twfth9/PiZero_RTL_Panadapter/README.md

# PiZero_RTL_Panadapter
Rasp Pi Zero, RTLSDR-based panadapter module
