twfth9/PiZero_RTL_Panadapter/Modules/SDR_2832U_R820T2/SDR_2832U_R820T2.kicad_pcb

## KiCad design Modules/SDR_2832U_R820T2/SDR_2832U_R820T2.kicad_pcb (2026-09-03)

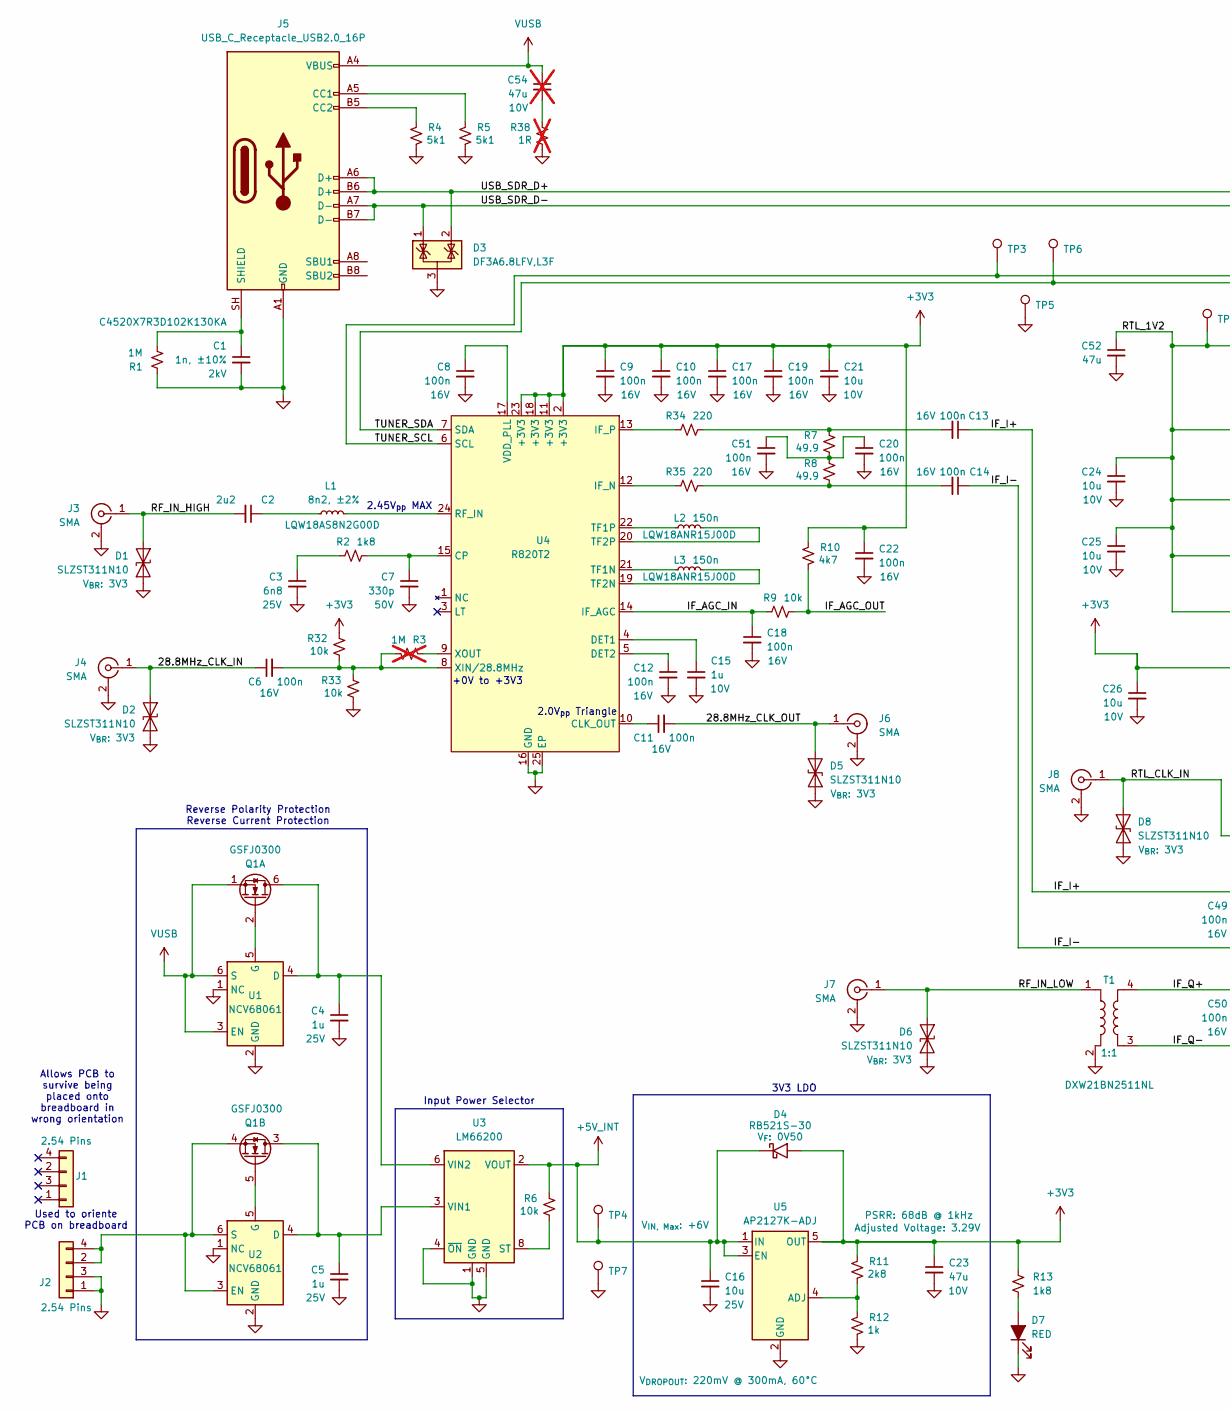
[picture p1: schematic SDR_2832U_R820T2.kicad_sch, part in row 1, column 1]

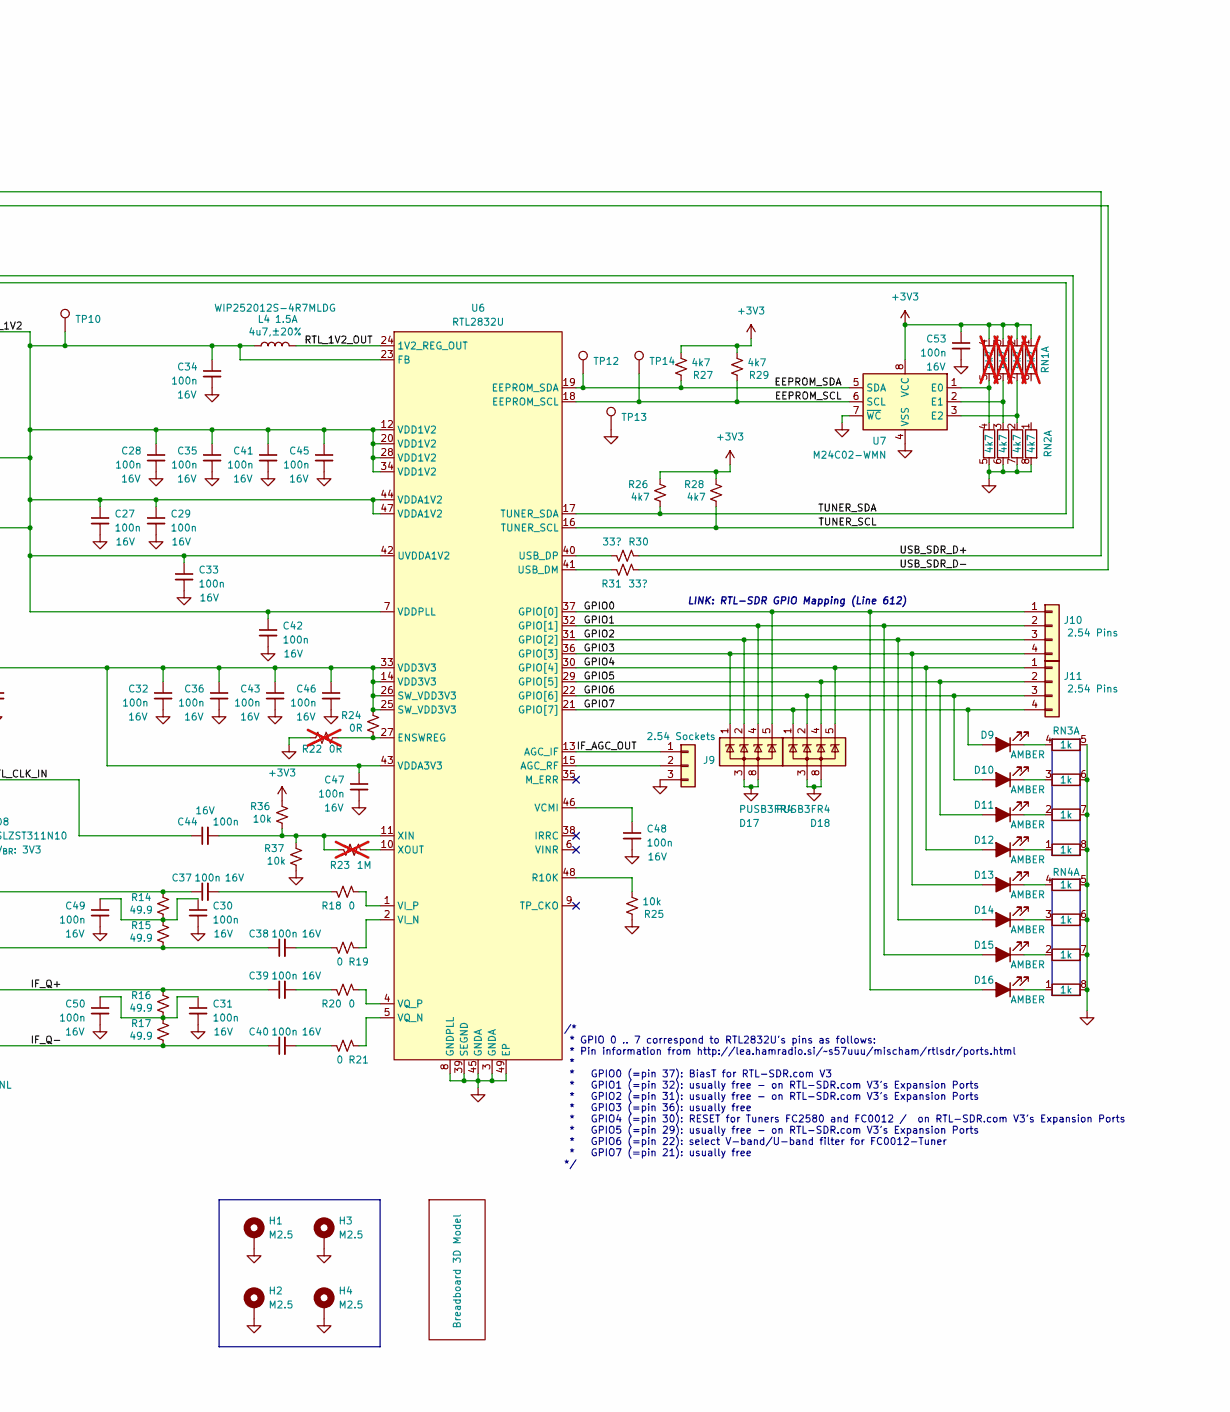
[picture p2: schematic SDR_2832U_R820T2.kicad_sch, part in row 1, column 2]

Parts:
C1: 1n, ±10%; C_1808_4520Metric; Voltage 2kV; Part Number C4520X7R3D102K130KA; DigiKey 445-2386-1-ND
C2: 2u2; Worthington_C_Narrow_0402_0603; Voltage 10V
C3: 6n8; Worthington_C_Narrow_0201; Voltage 25V; Manufacturer Part Number GMC02X5R682K25NT; DigiKey 4713-GMC02X5R682K25NTCT-ND
C4, C5: 1u; Worthington_C_Narrow_0402; Voltage 25V; Manufacturer Part Number GMC04X5R106M10NT; DigiKey 4713-GMC04X5R106M10NTCT-ND
C6, C8, C9, C10, C11, C12, C13, C14, C17, C18, C19, C20, C22, C27, C28, C29, C30, C31, C32, C33, C34, C35, C36, C37, C38, C39, C40, C41, C42, C43, C44, C45, C46, C47, C48, C49, C50, C51, C53: 100n; Worthington_C_Narrow_0201; Voltage 16V; Manufacturer Part Number C0603X6S1C104K030BC; DigiKey 445-15903-1-ND
C7: 330p; Worthington_C_Narrow_0201; Voltage 50V; Manufacturer Part Number GMC02X7R331J50NT; DigiKey 4713-GMC02X7R331J50NTCT-ND
C15: 1u; Worthington_C_Narrow_0201; Voltage 10V; Manufacturer Part Number GMC02X5R105K10NT; DigiKey 4713-GMC02X5R105K10NTCT-ND
C16: 10u; Worthington_C_Narrow_0402; Voltage 25V; Manufacturer Part Number GMC04X5R106M10NT; DigiKey 4713-GMC04X5R106M10NTCT-ND
C21, C24, C25, C26: 10u; Worthington_C_Narrow_0402; Voltage 10V; Manufacturer Part Number GMC04X5R106M10NT; DigiKey 4713-GMC04X5R106M10NTCT-ND
C23: 47u; Worthington_C_0805; Voltage 10V; Manufacturer Part Number GMC04X5R106M10NT; DigiKey 4713-GMC04X5R106M10NTCT-ND
C52: 47u; Worthington_C_Narrow_0603
C54: 47u; Worthington_C_0805; Voltage 10V; Manufacturer Part Number GMC04X5R106M10NT; DigiKey 4713-GMC04X5R106M10NTCT-ND; not fitted
D1, D2, D5, D6, D8: SLZST311N10; D_SOD-882; Part Number SLZST311N10; DigiKey 5399-SLZST311N10CT-ND
D3: DF3A6.8LFV,L3F; SOT-723
D4: RB521S-30; D_SOD-523; Part Number RB521S-30; DigiKey 5399-RB521S-30CT-ND
D7: RED; Worthington_LED_0402
D9, D10, D11, D12, D13, D14, D15, D16: AMBER; Worthington_LED_0402
D17, D18: PUSB3FR4; Diodes_UDFN-10_1x2.5mm_P0.5mm
H1, H2, H3, H4: M2.5; MountingHole_2.7mm_M2.5_ISO7380_Pad
J1, J2: 2.54 Pins; PinHeader_2x02_P2.54mm_Vertical
J3, J4, J6, J7, J8: SMA; SMA_Amphenol_132289_EdgeMount
J5: USB_C_Receptacle_USB2.0_16P; USB_C_Receptacle_GCT_USB4105-xx-A_16P_TopMnt_Horizontal
J9: 2.54 Sockets; PinHeader_1x03_P2.54mm_Vertical
J10, J11: 2.54 Pins; PinHeader_1x04_P2.54mm_Vertical
L1: 8n2, ±2%; Worthington_L_Narrow_0603_RF; Manufacturer Part Number LQW18AS8N2G00D; DigiKey 490-LQW18AS8N2G00DCT-ND
L2, L3: 150n; Worthington_L_Narrow_0603_RF; Manufacturer Part Number LQW18ANR15J00D; DigiKey 490-6924-1-ND
L4: 4u7,±20%; L_1008_2520Metric; Manufacturer Part Number WIP252012S-4R7MLDG; DigiKey 3526-WIP252012S-4R7MLDGCT-ND
Q1: GSFJ0300; SOT-563; Part Number GSFJ0300; DigiKey 4786-GSFJ0300CT-ND
R1: 1M; Worthington_R_Narrow_0201
R2, R13: 1k8; Worthington_R_Narrow_0201
R3, R23: 1M; Worthington_R_Narrow_0201; not fitted
R4, R5: 5k1; Worthington_R_Narrow_0201
R6, R9, R25, R32, R33, R36, R37: 10k; Worthington_R_Narrow_0201
R7, R8, R14, R15, R16, R17: 49.9; Worthington_R_Narrow_0201
R10, R26, R27, R28, R29: 4k7; Worthington_R_Narrow_0201
R11: 2k8; Worthington_R_Narrow_0201
R12: 1k; Worthington_R_Narrow_0201
R18, R19, R20, R21: 0; Worthington_R_Narrow_0201
R22: 0R; Worthington_R_Narrow_0201; not fitted
R24: 0R; Worthington_R_Narrow_0201
R30, R31: 33?; Worthington_R_Narrow_0201
R34, R35: 220; Worthington_R_Narrow_0201
R38: 1R; R_0805_2012Metric; not fitted
RN1: 4k7; RESCAXE80P320X160X70-8N; DigiKey Part CAT16-4702F4LFCT-ND; not fitted
RN2: 4k7; RESCAXE80P320X160X70-8N; DigiKey Part CAT16-4702F4LFCT-ND
RN3, RN4: 1k; RESCAXE80P320X160X70-8N; DigiKey Part CAT16-4702F4LFCT-ND
S1: Breadboard 3D Model; Breadboard_400
T1: DXW21BN2511NL; XFMR_ATB2012-50011-T000
TP3, TP4, TP5, TP6, TP7, TP10, TP12, TP13, TP14: TestPoint; TestPoint_Keystone_5000-5004_Miniature
U1, U2: NCV68061; TSOP-6_1.65x3.05mm_P0.95mm; DigiKey 488-NCV68061SNAIT1GCT-ND
U3: LM66200; SOT-583-8
U4: R820T2; QFN-24-1EP_4x4mm_P0.5mm_EP2.15x2.15mm_ThermalVias
U5: AP2127K-ADJ; SOT-23-5; Adjusted Voltage 3.29V; Part Number AP2127K-ADJTRG1; DigiKey AP2127K-ADJTRG1DICT-ND
U6: RTL2832U; QFN-48-1EP_6x6mm_P0.4mm_EP4.2x4.2mm_ThermalVias
U7: M24C02-WMN; SOIC-8_3.9x4.9mm_P1.27mm

Connections:
+3V3: C9.1, C10.1, C17.1, C19.1, C21.1, C22.1, C23.1, C26.1, C32.1, C36.1, C43.1, C46.1, C47.1, C53.1, D4.2 (A), R10.2, R11.2, R13.1, R24.2, R26.2, R27.1, R28.2, R29.1, R32.2, R36.2, RN1.1 (4), RN1.2, RN1.3, RN1.4, U4.2 (+3V3), U4.11 (+3V3), U4.18 (+3V3), U4.23 (+3V3), U5.5 (OUT), U6.14 (VDD3V3), U6.25 (SW_VDD3V3), U6.26 (SW_VDD3V3), U6.33 (VDD3V3), U6.43 (VDDA3V3), U7.8 (VCC)
+5V_INT: C16.1, D4.1 (K), R6.2, TP4.1 (1_1), U3.2 (VOUT), U3.7 (VOUT), U5.1 (IN), U5.3 (EN)
/28.8MHz_CLK_IN: C6.1, D2.2 (A2), J4.1 (In)
/28.8MHz_CLK_OUT: C11.2, D5.2 (A2), J6.1 (In)
/EEPROM_SCL: R29.2, TP14.1 (1_1), U6.18 (EEPROM_SCL), U7.6 (SCL)
/EEPROM_SDA: R27.2, TP12.1 (1_1), U6.19 (EEPROM_SDA), U7.5 (SDA)
/GPIO0: D16.2 (A), D17.5 (K), J10.1, U6.37 (GPIO[0])
/GPIO1: D15.2 (A), D17.4 (K), J10.2, U6.32 (GPIO[1])
/GPIO2: D14.2 (A), D17.2 (K), J10.3, U6.31 (GPIO[2])
/GPIO3: D13.2 (A), D17.1 (K), J10.4, U6.36 (GPIO[3])
/GPIO4: D12.2 (A), D18.5 (K), J11.1, U6.30 (GPIO[4])
/GPIO5: D11.2 (A), D18.4 (K), J11.2, U6.29 (GPIO[5])
/GPIO6: D10.2 (A), D18.2 (K), J11.3, U6.22 (GPIO[6])
/GPIO7: D9.2 (A), D18.1 (K), J11.4, U6.21 (GPIO[7])
/IF_AGC_IN: C18.1, R9.1, U4.14 (IF_AGC)
/IF_AGC_OUT: J9.1, R9.2, R10.1, U6.13 (AGC_IF)
/IF_I+: C13.1, C37.1, R14.2
/IF_I-: C14.1, C38.1, R15.1
/IF_Q+: C39.1, R16.2, T1.4
/IF_Q-: C40.1, R17.1, T1.3
/RF_IN_HIGH: C2.2, D1.2 (A2), J3.1 (In)
/RF_IN_LOW: D6.2 (A2), J7.1 (In), T1.1
/RTL_1V2: C24.1, C25.1, C27.1, C28.1, C29.1, C33.1, C34.1, C35.1, C41.1, C42.1, C45.1, C52.1, L4.2, TP10.1 (1_1), U6.7 (VDDPLL), U6.12 (VDD1V2), U6.20 (VDD1V2), U6.23 (FB), U6.28 (VDD1V2), U6.34 (VDD1V2), U6.42 (UVDDA1V2), U6.44 (VDDA1V2), U6.47 (VDDA1V2)
/RTL_1V2_OUT: L4.1, U6.24 (1V2_REG_OUT)
/RTL_CLK_IN: C44.1, D8.2 (A2), J8.1 (In)
/TUNER_SCL: R28.1, TP3.1 (1_1), U4.6 (SCL), U6.16 (TUNER_SCL)
/TUNER_SDA: R26.1, TP6.1 (1_1), U4.7 (SDA), U6.17 (TUNER_SDA)
/USB_SDR_D+: D3.2 (K), J5.A6 (D+), J5.B6 (D+), R30.1
/USB_SDR_D-: D3.1 (K), J5.A7 (D-), J5.B7 (D-), R31.2
GND: C1.2, C3.2, C4.2, C5.2, C7.2, C8.2, C9.2, C10.2, C12.2, C15.2, C16.2, C17.2, C18.2, C19.2, C20.2, C21.2, C22.2, C23.2, C24.2, C25.2, C26.2, C27.2, C28.2, C29.2, C30.2, C31.2, C32.2, C33.2, C34.2, C35.2, C36.2, C41.2, C42.2, C43.2, C45.2, C46.2, C47.2, C48.2, C49.2, C50.2, C51.2, C52.2, C53.2, D1.1 (A1), D2.1 (A1), D3.3 (A), D5.1 (A1), D6.1 (A1), D7.1 (K), D8.1 (A1), D17.3 (A), D17.8 (A), D18.3 (A), D18.8 (A), H1.1 (1_1), H2.1 (1_1), H3.1 (1_1), H4.1 (1_1), J2.1, J2.3, J3.2 (Ext), J4.2 (Ext), J5.A1 (GND), J5.A12 (GND), J5.B1 (GND), J5.B12 (GND), J6.2 (Ext), J7.2 (Ext), J8.2 (Ext), J9.3, R1.1, R4.1, R5.1, R12.1, R22.2, R25.2, R33.1, R37.1, R38.1, RN2.5, RN2.6, RN2.7 (5), RN2.8, RN3.5, RN3.6, RN3.7 (5), RN3.8, RN4.5, RN4.6, RN4.7 (5), RN4.8, T1.2, TP5.1 (1_1), TP7.1 (1_1), TP13.1 (1_1), U1.1 (NC), U1.2 (GND), U2.1 (NC), U2.2 (GND), U3.1 (GND), U3.4 (~ON), U3.5 (GND), U4.16 (GND), U4.25 (EP), U5.2 (GND), U6.3 (GNDA), U6.8 (GNDPLL), U6.39 (SEGND), U6.45 (GNDA), U6.49 (EP), U7.4 (VSS), U7.7 (~WC); also elsewhere on the board
unnamed: C2.1, L1.1
unnamed: C3.1, R2.1
unnamed: C13.2, R7.2, R34.2
unnamed: C14.2, R8.1, R35.2
unnamed: C20.1, C51.1, R7.1, R8.2
unnamed: C30.1, C49.1, R14.1, R15.2
unnamed: C31.1, C50.1, R16.1, R17.2
unnamed: C37.2, R18.1
unnamed: C38.2, R19.1
unnamed: C39.2, R20.1
unnamed: C40.2, R21.1
unnamed: C54.2, R38.2
unnamed: D7.2 (A), R13.2
unnamed: D9.1 (K), RN3.4
unnamed: D10.1 (K), RN3.3
unnamed: D11.1 (K), RN3.2
unnamed: D12.1 (K), RN3.1 (4)
unnamed: D13.1 (K), RN4.4
unnamed: D14.1 (K), RN4.3
unnamed: D15.1 (K), RN4.2
unnamed: D16.1 (K), RN4.1 (4)
unnamed: J2.2, J2.4, Q1.4 (S), U2.3 (EN), U2.6 (S)
unnamed: J5.A5 (CC1), R5.2
unnamed: J5.B5 (CC2), R4.2
unnamed: C1.1, J5.SH (SHIELD), R1.2
unnamed: J9.2, U6.15 (AGC_RF)
unnamed: C4.1, Q1.6 (D), U1.4 (D), U3.6 (VIN2)
unnamed: Q1.2 (G), U1.5 (G)
unnamed: C5.1, Q1.3 (D), U2.4 (D), U3.3 (VIN1)
unnamed: Q1.5 (G), U2.5 (G)
unnamed: RN1.7 (5), RN2.2, U7.3 (E2)
unnamed: R6.1, U3.8 (ST)
unnamed: C11.1, U4.10 (CLK_OUT)
unnamed: C7.1, R2.2, U4.15 (CP)
unnamed: C15.1, U4.4 (DET1)
unnamed: C12.1, U4.5 (DET2)
unnamed: R35.1, U4.12 (IF_N)
unnamed: R34.1, U4.13 (IF_P)
unnamed: L1.2, U4.24 (RF_IN)
unnamed: L3.1, U4.21 (TF1N)
unnamed: L2.1, U4.22 (TF1P)
unnamed: L3.2, U4.19 (TF2N)
unnamed: L2.2, U4.20 (TF2P)
unnamed: C8.1, U4.17 (VDD_PLL)
unnamed: C6.2, R3.2, R32.1, R33.2, U4.8 (XIN/28.8MHz)
unnamed: R3.1, U4.9 (XOUT)
unnamed: R11.1, R12.2, U5.4 (ADJ)
unnamed: R22.1, R24.1, U6.27 (ENSWREG)
unnamed: R25.1, U6.48 (R10K)
unnamed: R31.1, U6.41 (USB_DM)
unnamed: R30.2, U6.40 (USB_DP)
unnamed: C48.1, U6.46 (VCMI)
unnamed: R19.2, U6.2 (VI_N)
unnamed: R18.2, U6.1 (VI_P)
unnamed: R21.2, U6.5 (VQ_N)
unnamed: R20.2, U6.4 (VQ_P)
unnamed: C44.2, R23.1, R36.1, R37.2, U6.11 (XIN)
unnamed: R23.2, U6.10 (XOUT)
unnamed: RN1.5, RN2.4, U7.1 (E0)
unnamed: RN1.6, RN2.3, U7.2 (E1)
VUSB: C54.1, J5.A4 (VBUS), J5.A9 (VBUS), J5.B4 (VBUS), J5.B9 (VBUS), Q1.1 (S), U1.3 (EN), U1.6 (S)

Notes on the sheet:
Used to oriente PCB on breadboard
Allows PCB to survive being placed onto breadboard in wrong orientation
2.45V_{pp} MAX
/* * GPIO 0 .. 7 correspond to RTL2832U's pins as follows: * Pin information from http://lea.hamradio.si/~s57uuu/mischam/rtlsdr/ports.html * * GPIO0 (=pin 37): BiasT for RTL-SDR.com V3 * GPIO1 (=pin 32): usually free - on RTL-SDR.com V3's Expansion Ports * GPIO2 (=pin 31): usually free - on RTL-SDR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
+0V to +3V3
3V3 LDO
Input Power Selector
Reverse Polarity Protection Reverse Current Protection
LINK: RTL-SDR GPIO Mapping (Line 612)
2.0V_{pp} Triangle

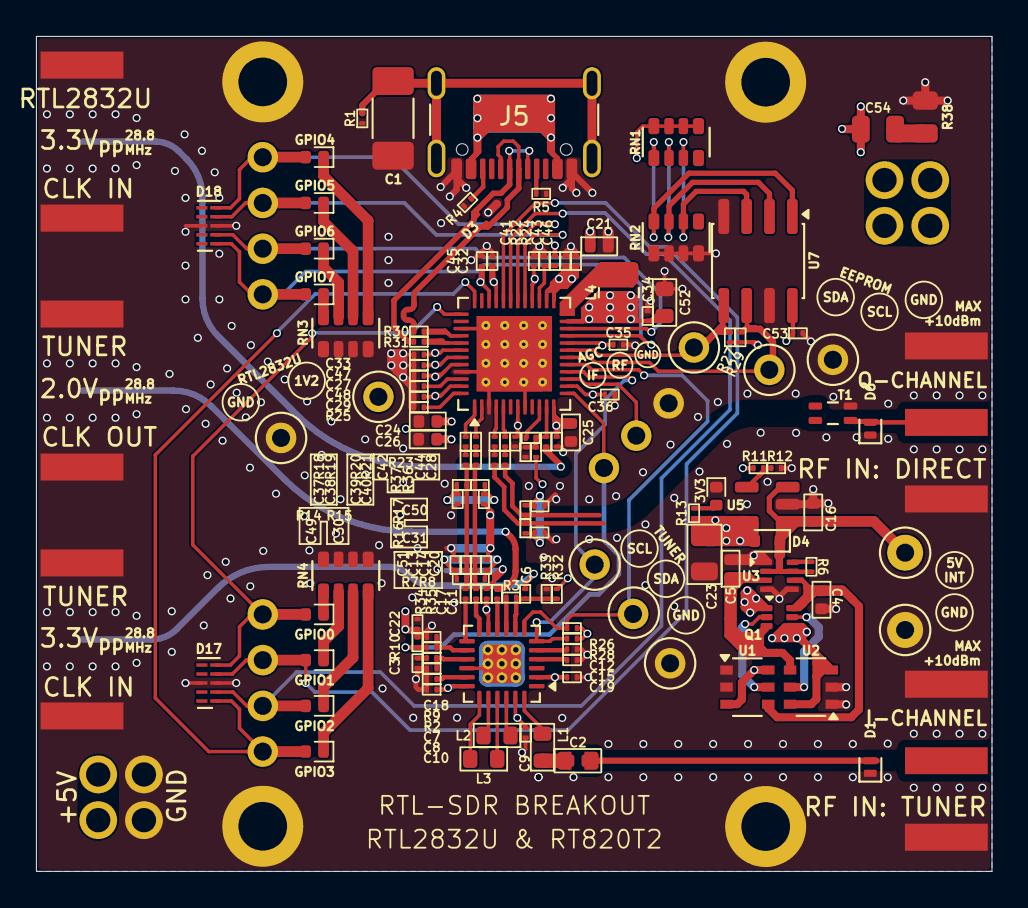
[picture p3: board SDR_2832U_R820T2.kicad_pcb from above]

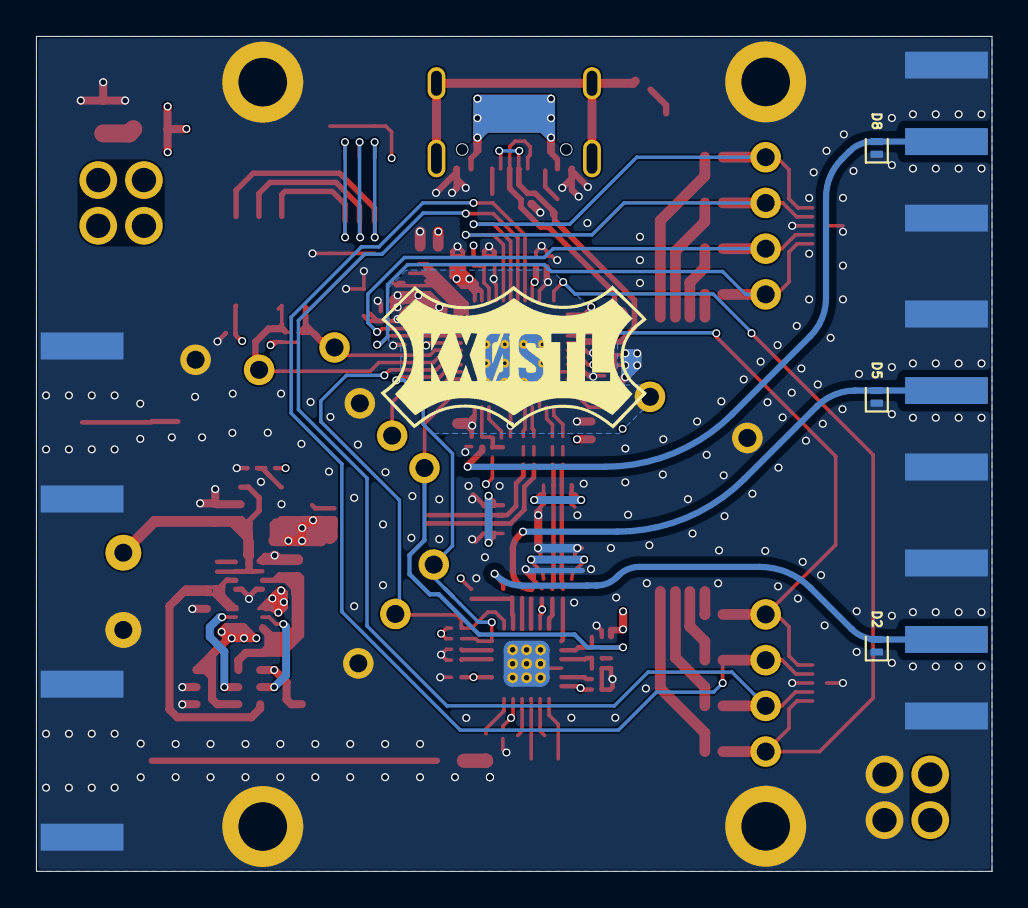
[picture p4: board SDR_2832U_R820T2.kicad_pcb from below]

Board: 4 copper layers, 53.1 x 46.4 mm, 153 parts (8 on the bottom side), 91 nets.

Other parts of the board:
TP11: TestPoint; TestPoint_Keystone_5000-5004_Miniature

Their connections:
GND: TP11.1 (1_1); also elsewhere on the board
