twfth9/PiZero_RTL_Panadapter/Modules/ClockGen_Si5351X_QFN16/ClockGen_Si5351X_QFN16.kicad_pcb

## KiCad design Modules/ClockGen_Si5351X_QFN16/ClockGen_Si5351X_QFN16.kicad_pcb (2026-09-03)

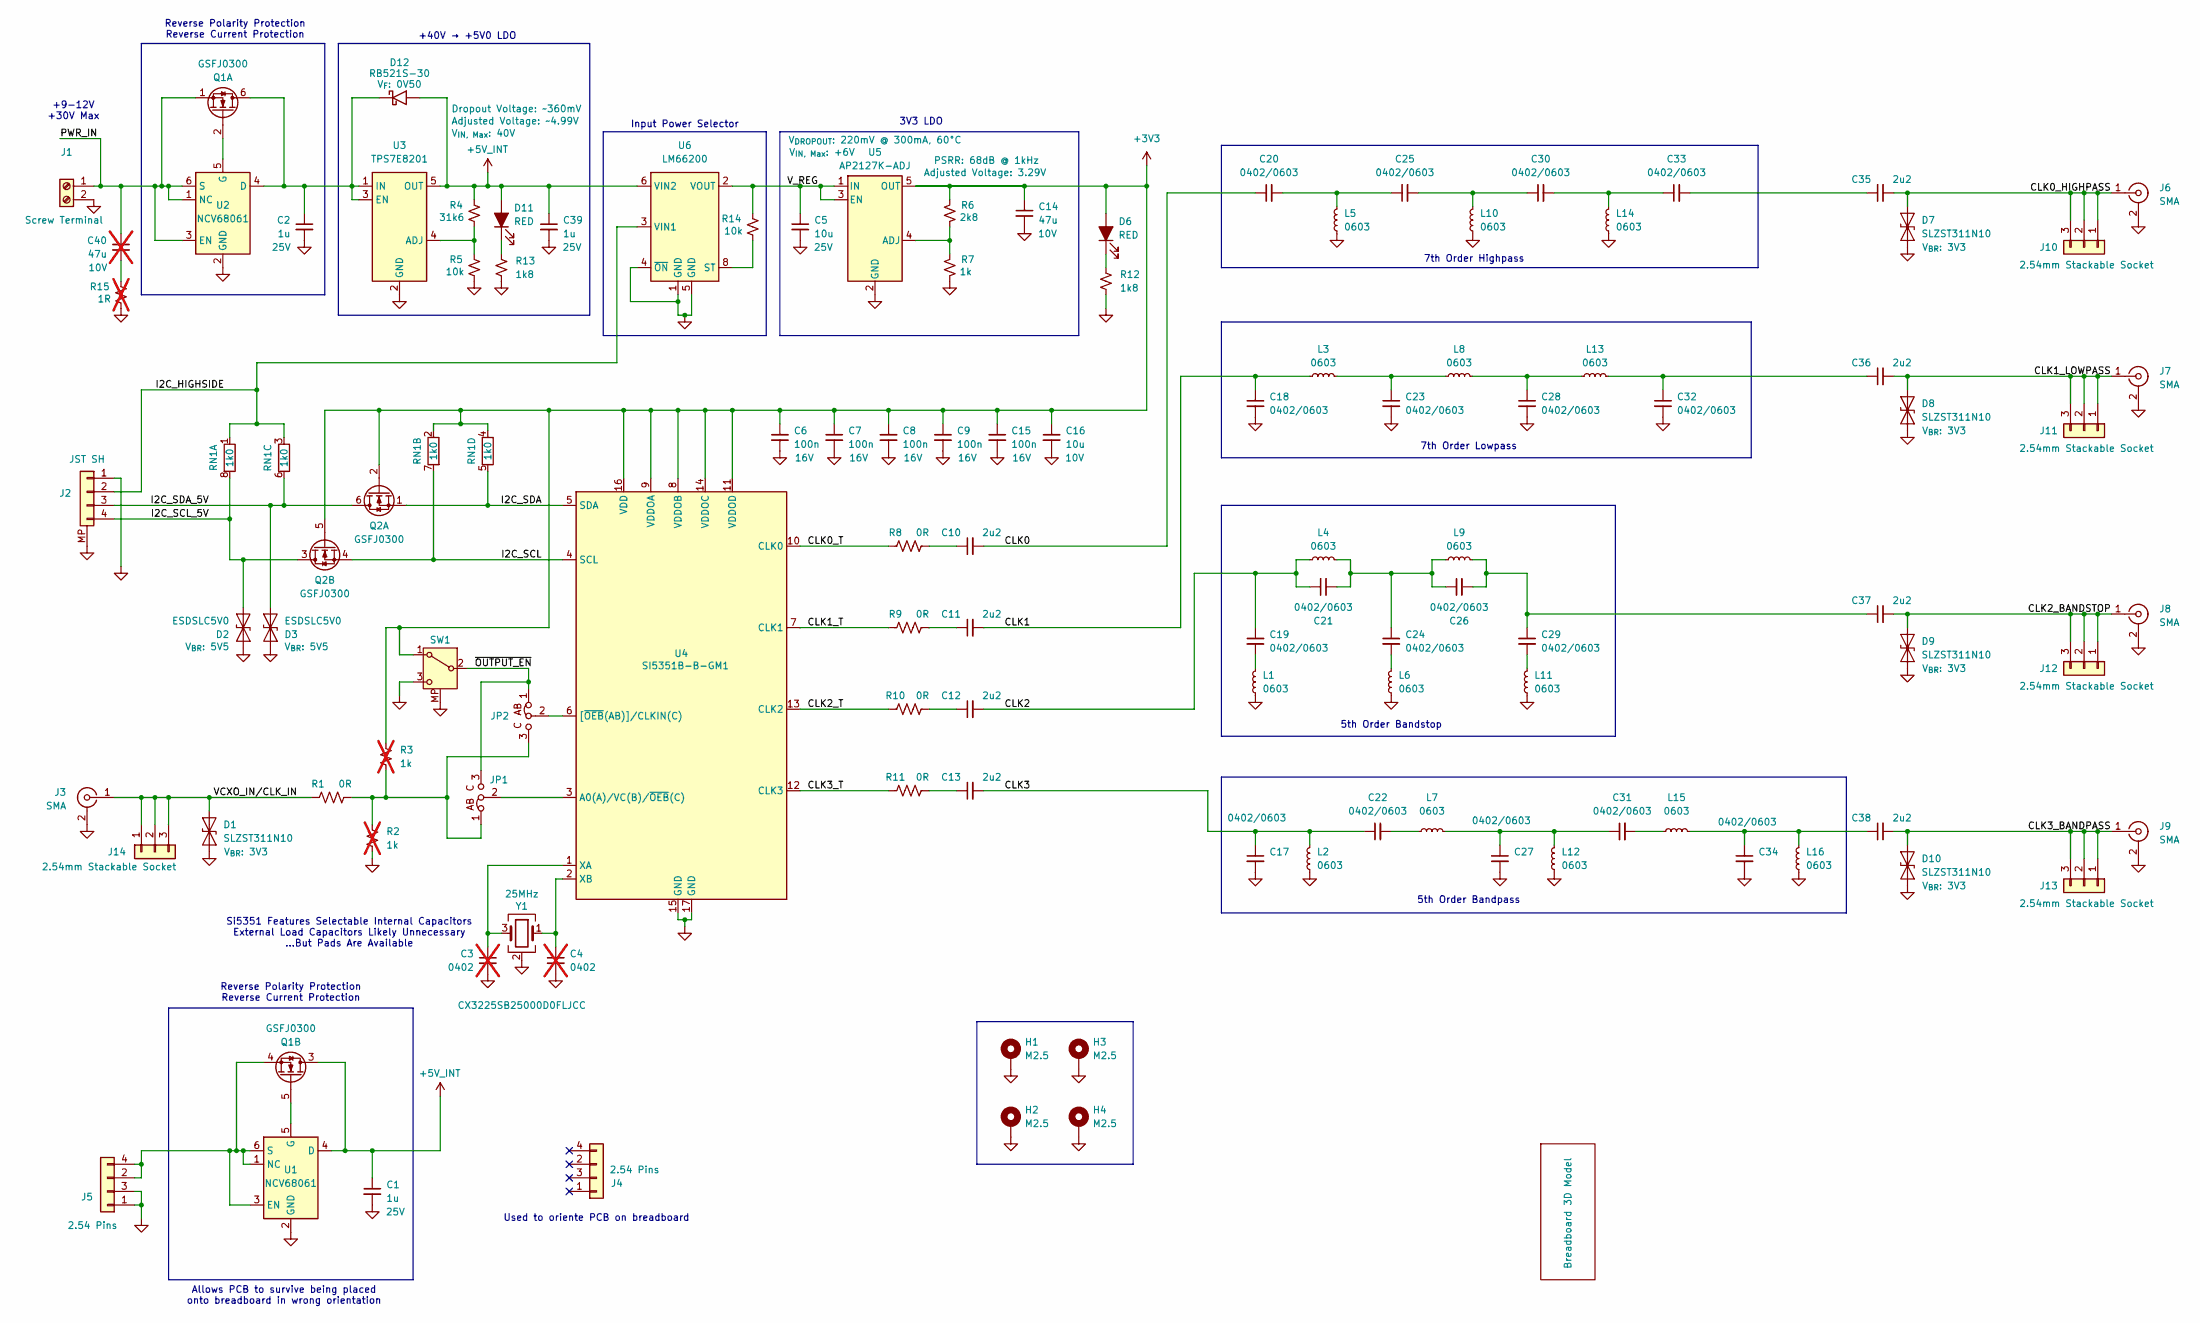
[picture p5: schematic ClockGen_Si5351X_QFN16.kicad_sch]

Parts:
C1, C2, C39: 1u; Worthington_C_Narrow_0402; Voltage 25V; Manufacturer Part Number GMC04X5R106M10NT; DigiKey 4713-GMC04X5R106M10NTCT-ND
C3, C4: 0402; Worthington_C_Narrow_0402; not fitted
C5: 10u; Worthington_C_Narrow_0402; Voltage 25V; Manufacturer Part Number GMC04X5R106M10NT; DigiKey 4713-GMC04X5R106M10NTCT-ND
C6, C7, C8, C9, C15: 100n; Worthington_C_Narrow_0201; Voltage 16V; Manufacturer Part Number C0603X6S1C104K030BC; DigiKey 445-15903-1-ND
C10, C11, C12, C13: 2u2; Worthington_C_Narrow_0402; Voltage 10V
C14: 47u; Worthington_C_0805; Voltage 10V; Manufacturer Part Number GMC04X5R106M10NT; DigiKey 4713-GMC04X5R106M10NTCT-ND
C16: 10u; Worthington_C_Narrow_0402; Voltage 10V; Manufacturer Part Number GMC04X5R106M10NT; DigiKey 4713-GMC04X5R106M10NTCT-ND
C17, C18, C19, C20, C21, C22, C23, C24, C25, C26, C27, C28, C29, C30, C31, C32, C33, C34: 0402/0603; Worthington_C_Narrow_0402_0603
C35, C36, C37, C38: 2u2; Worthington_C_Narrow_0402_0603; Voltage 10V
C40: 47u; Worthington_C_0805; Voltage 10V; Manufacturer Part Number GMC04X5R106M10NT; DigiKey 4713-GMC04X5R106M10NTCT-ND; not fitted
D1, D7, D8, D9, D10: SLZST311N10; D_SOD-882; Part Number SLZST311N10; DigiKey 5399-SLZST311N10CT-ND
D2, D3: ESDSLC5V0; D_SOD-882; Part Number 353-ESDSLC5V0L2B-TPCT-ND; DigiKey ESDSLC5V0L2B-TP
D6, D11: RED; Worthington_LED_0402
D12: RB521S-30; D_SOD-523; Part Number RB521S-30; DigiKey 5399-RB521S-30CT-ND
H1, H2, H3, H4: M2.5; MountingHole_2.7mm_M2.5_ISO7380_Pad
J1: Screw Terminal; TerminalBlock_Phoenix_MPT-0,5-2-2.54_1x02_P2.54mm_Horizontal; Part Number 1725656; DigiKey 277-1273-ND
J2: JST SH; JST_SH_SM04B-SRSS-TB_1x04-1MP_P1.00mm_Horizontal
J3, J6, J7, J8, J9: SMA; SMA_Molex_73251-2200_Horizontal
J4, J5: 2.54 Pins; PinHeader_2x02_P2.54mm_Vertical
J10, J11, J12, J13, J14: 2.54mm Stackable Socket; PinSocket_1x03_P2.54mm_Vertical
JP1, JP2: Jumper_3_Bridged12; SolderJumper-3_P2.0mm_Open_TrianglePad1.0x1.5mm
L1, L2, L3, L4, L5, L6, L7, L8, L9, L10, L11, L12, L13, L14, L15, L16: 0603; Worthington_L_Narrow_0603_RF
Q1, Q2: GSFJ0300; SOT-563; Part Number GSFJ0300; DigiKey 4786-GSFJ0300CT-ND
R1, R8, R9, R10, R11: 0R; Worthington_R_Narrow_0402
R2, R3: 1k; Worthington_R_Narrow_0402; not fitted
R4: 31k6; Worthington_R_Narrow_0201
R5, R14: 10k; Worthington_R_Narrow_0201
R6: 2k8; Worthington_R_Narrow_0201
R7: 1k; Worthington_R_Narrow_0201
R12, R13: 1k8; Worthington_R_Narrow_0201
R15: 1R; R_0805_2012Metric; not fitted
RN1: 1k0; RESCAXE80P320X160X70-8N; DigiKey Part CAT16-4702F4LFCT-ND
S1: Breadboard 3D Model; Breadboard_400
SW1: SW_SPDT; SW_Slide_SPDT_Straight_CK_OS102011MS2Q
U1, U2: NCV68061; TSOP-6_1.65x3.05mm_P0.95mm; DigiKey 488-NCV68061SNAIT1GCT-ND
U3: TPS7E8201; SOT-23-5; Adjusted Voltage ~4.99V; Dropout Voltage ~360mV
U4: SI5351B-B-GM1; QFN-16-1EP_3x3mm_P0.5mm_EP1.9x1.9mm_ThermalVias
U5: AP2127K-ADJ; SOT-23-5; Adjusted Voltage 3.29V; Part Number AP2127K-ADJTRG1; DigiKey AP2127K-ADJTRG1DICT-ND
U6: LM66200; SOT-583-8
Y1: 25MHz; Crystal_SMD_Kyocera_CX3225SB-4Pin_3.2x2.5mm

Connections:
+3V3: C6.1, C7.1, C8.1, C9.1, C14.1, C15.1, C16.1, D6.2 (A), Q2.2 (G), Q2.5 (G), R3.1, R6.2, RN1.2, RN1.4, SW1.1 (A), U4.8 (VDDOB), U4.9 (VDDOA), U4.11 (VDDOD), U4.14 (VDDOC), U4.16 (VDD), U5.5 (OUT)
+5V_INT: C1.1, C39.1, D11.2 (A), D12.2 (A), Q1.3 (D), R4.2, U1.4 (D), U3.5 (OUT), U6.6 (VIN2)
/CLK0: C10.2, C20.1
/CLK0_HIGHPASS: C35.2, D7.2 (A2), J6.1 (In), J10.1, J10.2, J10.3
/CLK0_T: R8.1, U4.10 (CLK0)
/CLK1: C11.2, C18.1, L3.1
/CLK1_LOWPASS: C36.2, D8.2 (A2), J7.1 (In), J11.1, J11.2, J11.3
/CLK1_T: R9.1, U4.7 (CLK1)
/CLK2: C12.2, C19.1, C21.1, L4.1
/CLK2_BANDSTOP: C37.2, D9.2 (A2), J8.1 (In), J12.1, J12.2, J12.3
/CLK2_T: R10.1, U4.13 (CLK2)
/CLK3: C13.2, C17.1, C22.1, L2.2
/CLK3_BANDPASS: C38.2, D10.2 (A2), J9.1 (In), J13.1, J13.2, J13.3
/CLK3_T: R11.1, U4.12 (CLK3)
/I2C_HIGHSIDE: J2.2, RN1.1 (4), RN1.3, U6.3 (VIN1)
/I2C_SCL: Q2.4 (S), RN1.7 (5), U4.4 (SCL)
/I2C_SCL_5V: D2.1 (A1), J2.4, Q2.3 (D), RN1.8
/I2C_SDA: Q2.1 (S), RN1.5, U4.5 (SDA)
/I2C_SDA_5V: D3.2 (A2), J2.3, Q2.6 (D), RN1.6
/PWR_IN: C40.1, J1.1, Q1.1 (S), U2.1 (NC), U2.3 (EN), U2.6 (S)
/VCXO_IN/CLK_IN: D1.2 (A2), J3.1 (In), J14.1, J14.2, J14.3, R1.1
/V_REG: C5.1, R14.2, U5.1 (IN), U5.3 (EN), U6.2 (VOUT), U6.7 (VOUT)
/~OUTPUT_EN: JP1.3 (B), JP2.1 (A), SW1.2 (B)
GND: C1.2, C2.2, C3.2, C4.2, C5.2, C6.2, C7.2, C8.2, C9.2, C14.2, C15.2, C16.2, C17.2, C18.2, C23.2, C27.2, C28.2, C32.2, C34.2, C39.2, D1.1 (A1), D2.2 (A2), D3.1 (A1), D7.1 (A1), D8.1 (A1), D9.1 (A1), D10.1 (A1), H1.1 (1_1), H2.1 (1_1), H3.1 (1_1), H4.1 (1_1), J1.2, J2.1, J2.MP, J3.2 (Ext), J5.1, J5.3, J6.2 (Ext), J7.2 (Ext), J8.2 (Ext), J9.2 (Ext), L1.1, L2.1, L5.1, L6.1, L10.1, L11.1, L12.1, L14.1, L16.1, R2.2, R5.1, R7.1, R12.2, R13.2, R15.1, SW1.3 (C), SW1.MP, U1.2 (GND), U2.2 (GND), U3.2 (GND), U4.15 (GND), U4.17 (GND), U5.2 (GND), U6.1 (GND), U6.4 (~ON), U6.5 (GND), Y1.2 (G), Y1.4 (G)
unnamed: C10.1, R8.2
unnamed: C11.1, R9.2
unnamed: C12.1, R10.2
unnamed: C13.1, R11.2
unnamed: C19.2, L1.2
unnamed: C20.2, C25.1, L5.2
unnamed: C21.2, C24.1, C26.1, L4.2, L9.1
unnamed: C22.2, L7.1
unnamed: C23.1, L3.2, L8.1
unnamed: C24.2, L6.2
unnamed: C25.2, C30.1, L10.2
unnamed: C26.2, C29.1, C37.1, L9.2
unnamed: C27.1, C31.1, L7.2, L12.2
unnamed: C28.1, L8.2, L13.1
unnamed: C29.2, L11.2
unnamed: C30.2, C33.1, L14.2
unnamed: C31.2, L15.1
unnamed: C32.1, C36.1, L13.2
unnamed: C33.2, C35.1
unnamed: C34.1, C38.1, L15.2, L16.2
unnamed: C40.2, R15.2
unnamed: D6.1 (K), R12.1
unnamed: D11.1 (K), R13.1
unnamed: C2.1, D12.1 (K), Q1.6 (D), U2.4 (D), U3.1 (IN), U3.3 (EN)
unnamed: J5.2, J5.4, Q1.4 (S), U1.1 (NC), U1.3 (EN), U1.6 (S)
unnamed: JP1.1 (A), JP2.3 (B), R1.2, R2.1, R3.2
unnamed: JP1.2 (C), U4.3 (A0(A)/VC(B)/~OEB(C))
unnamed: JP2.2 (C), U4.6 ([~OEB(AB)]/CLKIN(C))
unnamed: Q1.2 (G), U2.5 (G)
unnamed: Q1.5 (G), U1.5 (G)
unnamed: R4.1, R5.2, U3.4 (ADJ)
unnamed: C3.1, U4.1 (XA), Y1.3
unnamed: C4.1, U4.2 (XB), Y1.1
unnamed: R6.1, R7.2, U5.4 (ADJ)
unnamed: R14.1, U6.8 (ST)

Notes on the sheet:
7th Order Lowpass
5th Order Bandpass
Used to oriente PCB on breadboard
Reverse Polarity Protection Reverse Current Protection
5th Order Bandstop
Allows PCB to survive being placed onto breadboard in wrong orientation
+9-12V +30V Max
Input Power Selector
Si5351 Features Selectable Internal Capacitors External Load Capacitors Likely Unnecessary ...But Pads Are Available
7th Order Highpass
3V3 LDO
+40V → +5V0 LDO

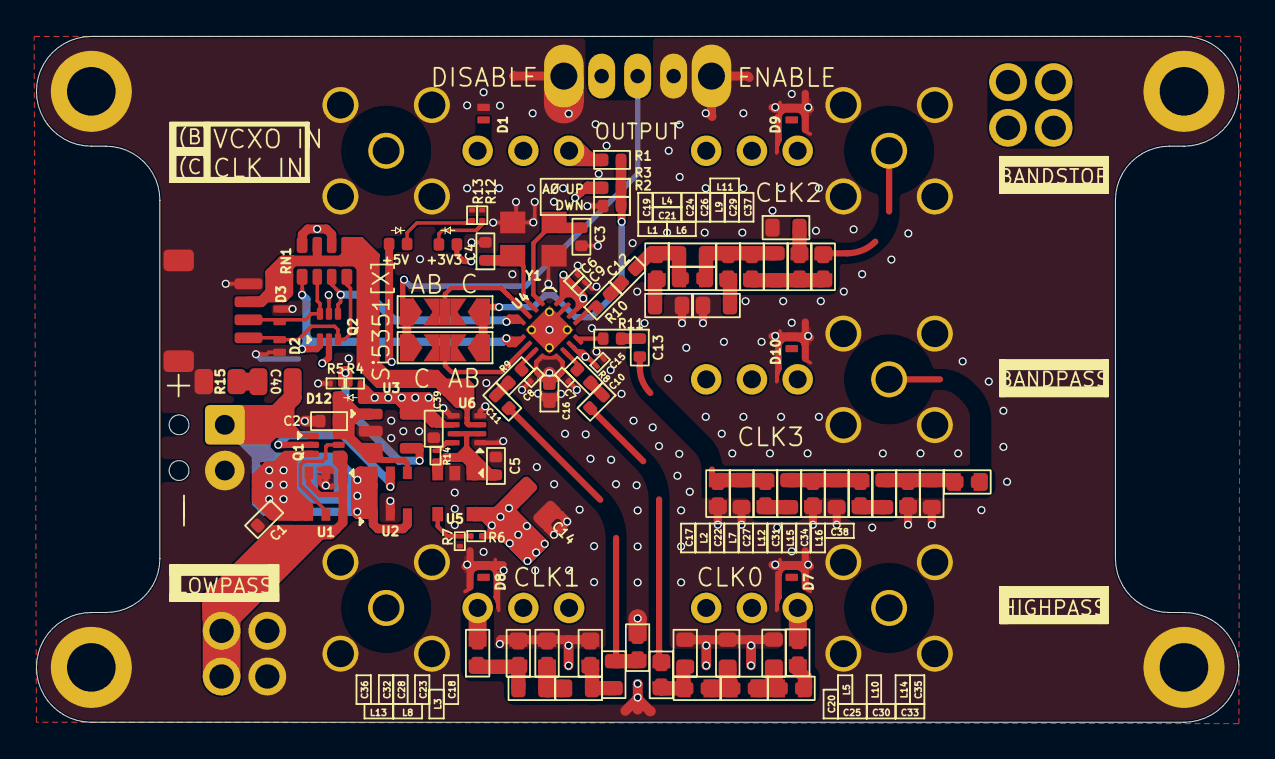
[picture p6: board ClockGen_Si5351X_QFN16.kicad_pcb from above]

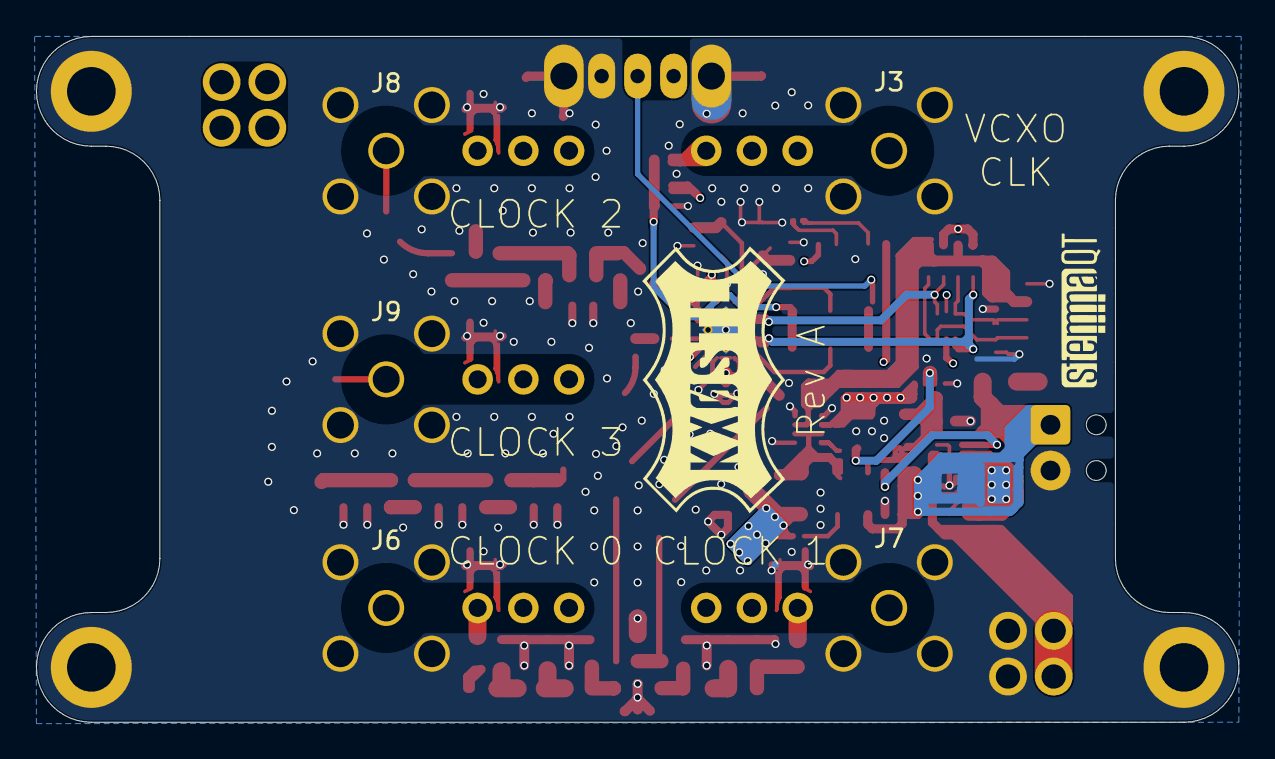
[picture p7: board ClockGen_Si5351X_QFN16.kicad_pcb from below]

Board: 4 copper layers, 66.8 x 38.1 mm, 113 parts (7 on the bottom side), 59 nets.
