twfth9/PiZero_RTL_Panadapter/Modules/PWR_RPM5.0_AP2114/PWR_RPM5.0_AP2114.kicad_pcb

## KiCad design Modules/PWR_RPM5.0_AP2114/PWR_RPM5.0_AP2114.kicad_pcb (2026-08-18)

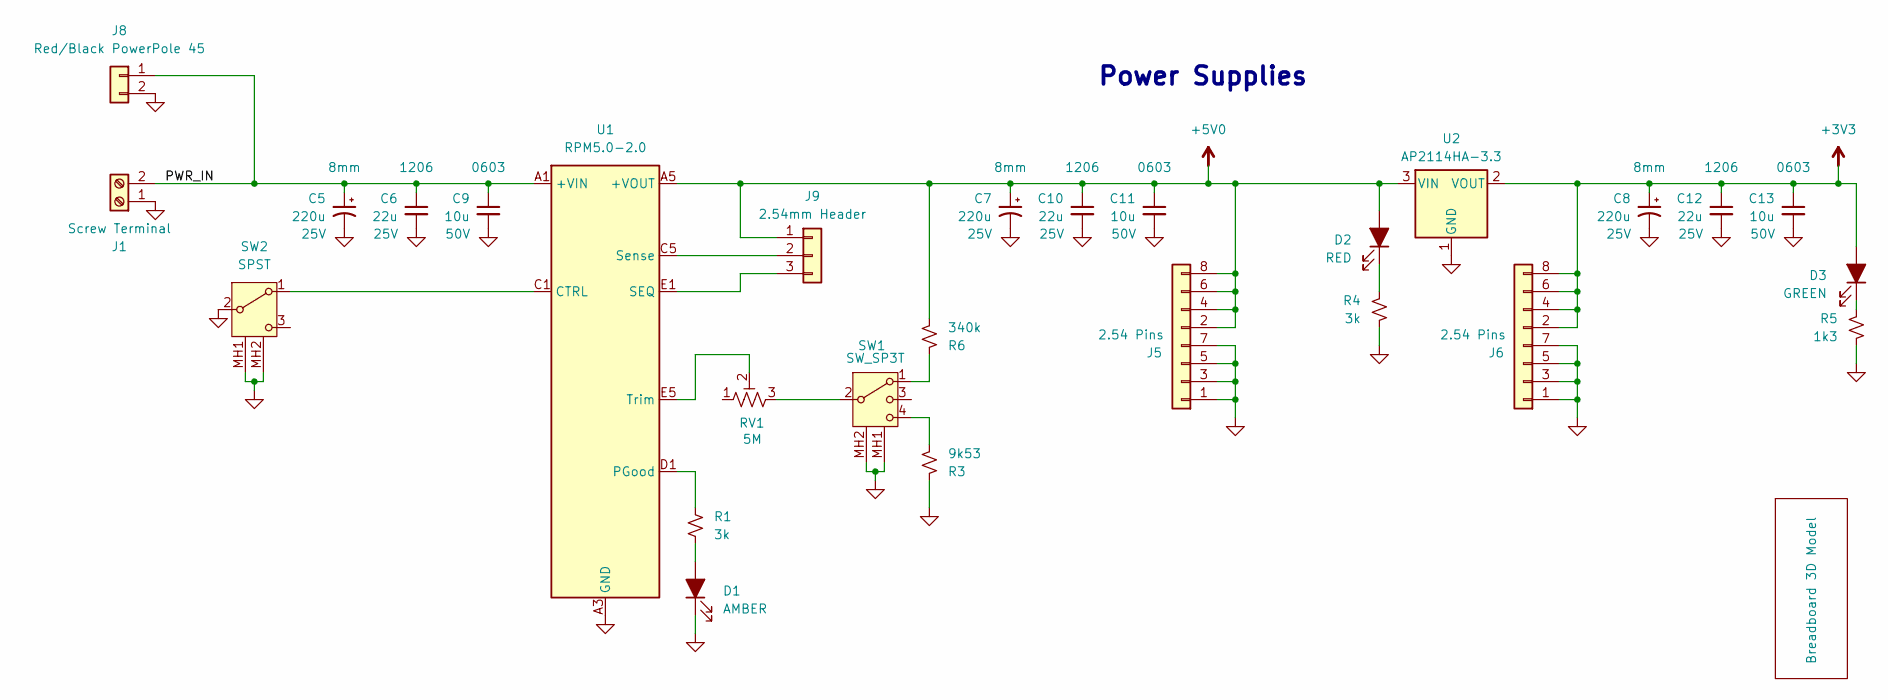
[picture p8: schematic PWR_RPM5.0_AP2114.kicad_sch]

Parts:
C5, C7, C8: 220u; CP_Radial_D6.3mm_P2.50mm; Voltage 25V; Manufacturer Part Number T491A336K010AT; DigiKey 399-5279-1-ND
C6, C10, C12: 22u; C_1206_3216Metric_Pad1.33x1.80mm_HandSolder; Voltage 25V; Part Number GMC31X5R226M25NT; DigiKey 4713-GMC31X5R226M25NTCT-ND
C9: 10u; C_0603_1608Metric; Voltage 50V; Part Number GMC10X5R106K25NT; DigiKey 4713-GMC10X5R106K25NTCT-ND
C11, C13: 10u; C_0603_1608Metric; Voltage 50V; Manufacturer Part Number GMC10X5R106K25NT; DigiKey 399-5279-1-ND
D1: AMBER; LED_D3.0mm; Part Number LTL-4291N; DigiKey 160-1968-ND
D2: RED; LED_D3.0mm; Part Number LLR3ED199G; DigiKey 5366-LLR3ED199G-ND
D3: GREEN; LED_D3.0mm; Part Number BL-BGE1V5D-AT; DigiKey BL-BGE1V5D-AT-ND
J1: Screw Terminal; TerminalBlock_Phoenix_MPT-0,5-2-2.54_1x02_P2.54mm_Horizontal; Part Number 1725656; DigiKey 277-1273-ND
J5, J6: 2.54 Pins; PinHeader_2x04_P2.54mm_Vertical
J8: Red/Black PowerPole 45; APP_ASMPR45-1X2-RK; Part Number ASMPR45-1X2-RK; DigiKey 2243-ASMPR45-1X2-RK-ND
J9: 2.54mm Header; PinHeader_1x03_P2.54mm_Vertical
R1, R4: 3k; R_0402_1005Metric; Part Number RM04F3001CT; DigiKey 4713-RM04F3001CT-ND
R3: 9k53; R_0402_1005Metric; Part Number RM04F9531CT; DigiKey 4713-RM04F9531CT-ND
R5: 1k3; R_0402_1005Metric; Part Number RM04F1301CT; DigiKey 4713-RM04F1301CT-ND
R6: 340k; R_0402_1005Metric; Part Number RM04F3403CT; DigiKey 4713-RM04F3403CT-ND
RV1: 5M; Potentiometer_Bourns_3299Y_Vertical; Part Number 3299Y-1-505LF; DigiKey 3299Y-505LF-ND
S1: Breadboard 3D Model; Breadboard_400
SW1: SW_SP3T; OS103011MA7QP1; Part Number OS103011MA7QP1; DigiKey CKN9561-ND
SW2: SPST; SW_Slide_SPDT_Angled_CK_OS102011MA1Q; Part Number OS102011MA1QN1; DigiKey CKN9559-ND
U1: RPM5.0-2.0; Converter_DCDC_RECOM_RPMx.x-x.0; Part Number RPM5.0-2.0-CT; DigiKey 945-3455-ND
U2: AP2114HA-3.3; SOT-223; Part Number AP2114HA-3.3TRG1; DigiKey AP2114HA-3.3TRG1DICT-ND

Connections:
+3V3: C8.1, C12.1, C13.1, D3.2 (A), J6.2, J6.4, J6.6, J6.8, U2.2 (VOUT)
+5V0: C7.1, C10.1, C11.1, D2.2 (A), J5.2, J5.4, J5.6, J5.8, J9.1, R6.2, U1.A5 (+VOUT), U1.B5 (+VOUT), U2.3 (VIN)
/PWR_IN: C5.1, C6.1, C9.1, J1.2, J8.1, U1.A1 (+VIN), U1.A2 (+VIN)
GND: C5.2, C6.2, C7.2, C8.2, C9.2, C10.2, C11.2, C12.2, C13.2, D1.1 (K), J1.1, J5.1, J5.3, J5.5, J5.7, J6.1, J6.3, J6.5, J6.7, J8.2, R3.1, R4.2, R5.2, SW1.MH1 (MH), SW1.MH2 (MH), SW2.2 (B), SW2.MH1, SW2.MH2, U1.A3 (GND), U1.A4 (GND), U1.B1 (GND), U1.B2 (GND), U1.B3 (GND), U1.B4 (GND), U1.C2 (GND), U1.C3 (GND), U1.C4 (GND), U1.D2 (GND), U1.D3 (GND), U1.D4 (GND), U1.D5 (GND), U1.E3 (GND), U1.E4 (GND), U2.1 (GND), U2.4 (GND)
unnamed: D1.2 (A), R1.2
unnamed: D2.1 (K), R4.1
unnamed: D3.1 (K), R5.1
unnamed: J9.2, U1.C5 (Sense)
unnamed: J9.3, U1.E1 (SEQ)
unnamed: R3.2, SW1.4
unnamed: R6.1, SW1.1
unnamed: RV1.3, SW1.2
unnamed: SW2.1 (A), U1.C1 (CTRL)
unnamed: R1.1, U1.D1 (PGood)
unnamed: RV1.2, U1.E5 (Trim)

Notes on the sheet:
Power Supplies
