twfth9/PiZero_RTL_Panadapter/Modules/PWR_RPM5.0_AP2114/PWR_RPM5.0_AP2114.kicad_pcb

## KiCad design Modules/PWR_RPM5.0_AP2114/PWR_RPM5.0_AP2114.kicad_pcb (continued)

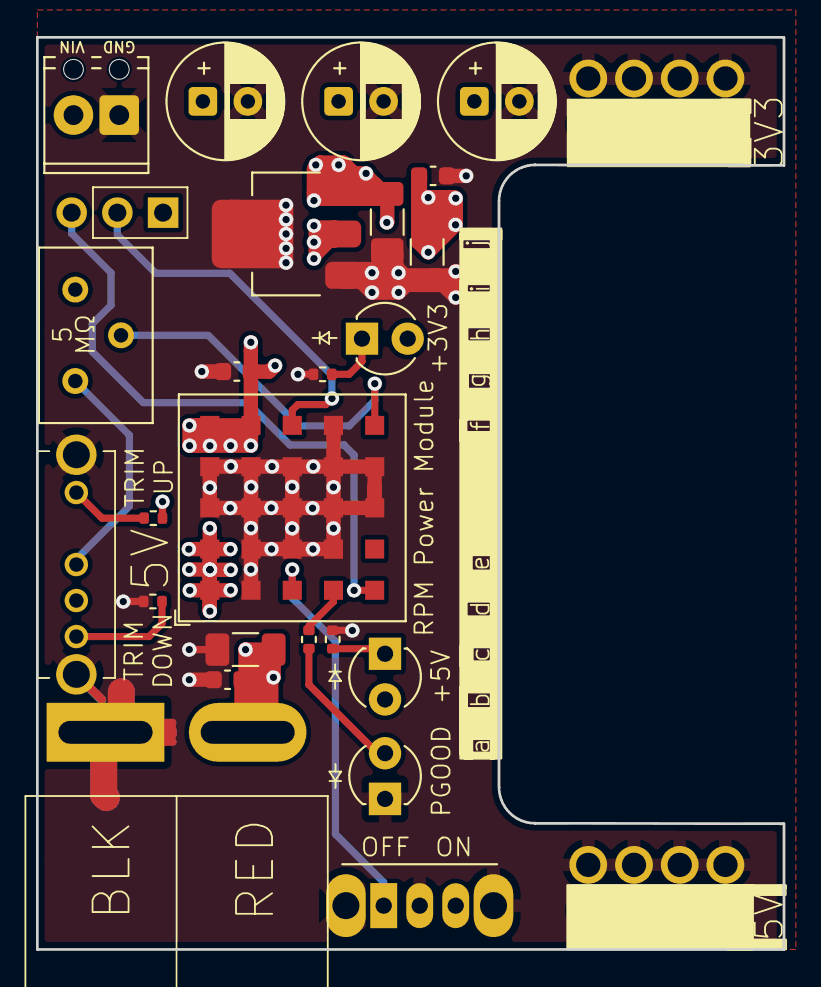
[picture p9: board PWR_RPM5.0_AP2114.kicad_pcb from above]

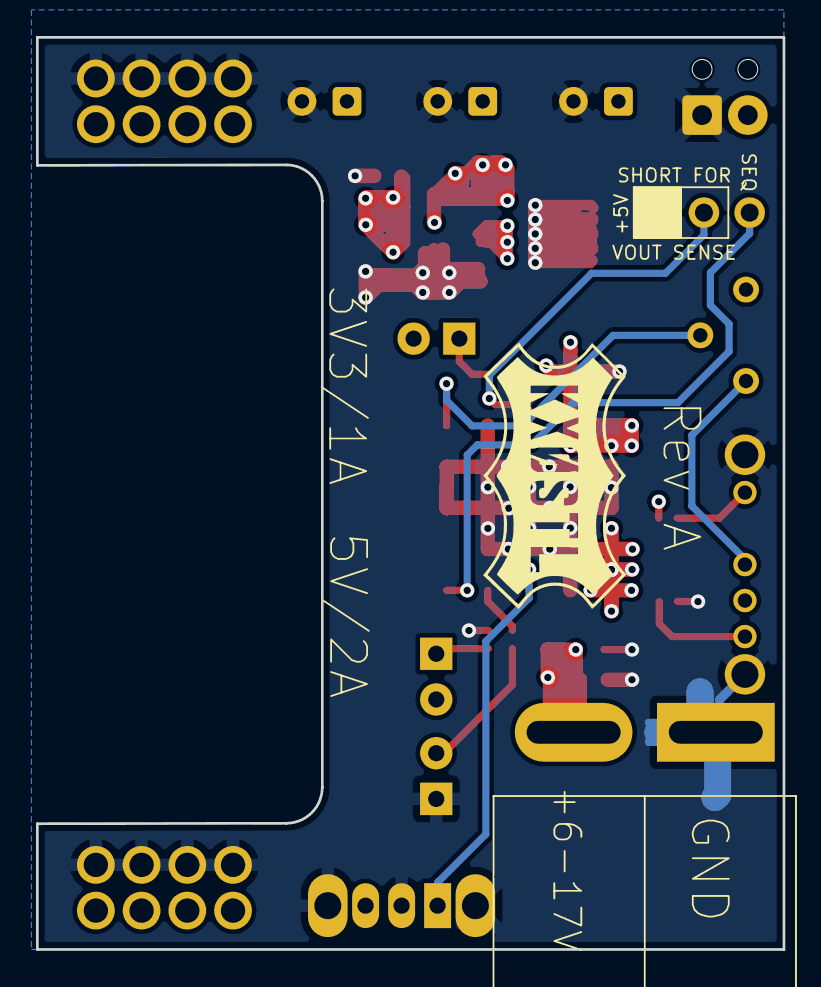
[picture p10: board PWR_RPM5.0_AP2114.kicad_pcb from below]

Board: 4 copper layers, 41.5 x 50.7 mm, 29 parts (3 on the bottom side), 15 nets.

Other parts of the board:
J8#2: Red/Black PowerPole 45; APP_ASMPR45-1X2-RK
