twfth9/PiZero_RTL_Panadapter/(commit log)

2026-07-24 Schematic progress
    [ETHERNET.kicad_sch, PiZero_RTL_Panadapter.kicad_pcb, PiZero_RTL_Panadapter.kicad_sch, R820T2.kicad_sch, RTL2832U.kicad_sch, RTLSDR.kicad_sch, SI5351.kicad_sch, USB_HUB.kicad_sch]
2026-07-24 Schematic progress
    I keep forgetting that I'm just making a panadapter here and not a full blown SDR...oops
    [ETHERNET.kicad_sch, HF_Frontend.kicad_sch, PiZero_RTL_Panadapter.kicad_pcb, PiZero_RTL_Panadapter.kicad_sch, R820T2.kicad_sch, RTL2832U.kicad_sch, SI5351.kicad_sch, USB_HUB.kicad_sch]
2026-07-28 Schematic and PCB progress
    [ETHERNET.kicad_sch, HF_Frontend.kicad_sch, IF_Buffer.kicad_sch, PiZero_RTL_Panadapter.kicad_pcb, PiZero_RTL_Panadapter.kicad_sch, R820T2.kicad_sch, RTL2832U.kicad_sch, SI5351.kicad_sch]
2026-07-30 PCB Layout Progress
    [HF_Frontend.kicad_sch, IF_Buffer.kicad_sch, PiZero_RTL_Panadapter.kicad_pcb, PiZero_RTL_Panadapter.kicad_sch, R820T2.kicad_sch, RTL2832U.kicad_sch, SI5351.kicad_sch, USB_HUB_FE1.1S.kicad_sch]
2026-07-30 PCB and schematic progress
    [ETHERNET.kicad_sch, PiZero_RTL_Panadapter.kicad_pcb, PiZero_RTL_Panadapter.kicad_sch, R820T2.kicad_sch, RTL2832U.kicad_sch, SI5351.kicad_sch]
2026-08-07 PCB progress
    [PiZero_RTL_Panadapter.kicad_pcb]
2026-08-07 PCB Routing Complete
    On to silkscreen...
    [PiZero_RTL_Panadapter.kicad_pcb, PiZero_RTL_Panadapter.kicad_sch]
2026-08-08 PCB Layout finished?
    [PiZero_RTL_Panadapter.kicad_pcb, PiZero_RTL_Panadapter.kicad_sch]
2026-08-10 Tweaked ETH_GND Clearances
    [PiZero_RTL_Panadapter.kicad_pcb]
2026-08-10 Small PCB layout tweaks
    Beautification, if you will...
    [HF_Frontend.kicad_sch, PiZero_RTL_Panadapter.kicad_pcb, PiZero_RTL_Panadapter.kicad_sch, RTL2832U.kicad_sch]
2026-08-10 Added Silkscreen Art & Labels
    [PiZero_RTL_Panadapter.kicad_pcb]
2026-08-11 Fixed Ethernet directive labels
    Was 90R and 100R, now just 100R
    [PiZero_RTL_Panadapter-B_Cu.gbl, PiZero_RTL_Panadapter-B_Mask.gbs, PiZero_RTL_Panadapter-B_Paste.gbp, PiZero_RTL_Panadapter-B_Silkscreen.gbo, PiZero_RTL_Panadapter-Edge_Cuts.gm1, PiZero_RTL_Panadapter-F_Cu.gtl, PiZero_RTL_Panadapter-F_Mask.gts, PiZero_RTL_Panadapter-F_Paste.gtp]
2026-08-13 Created breadboard power supply breakout module
    [ClockGen_Si5351X_QFN16.kicad_pcb, ClockGen_Si5351X_QFN16.kicad_sch, IF_Frontend_J310_BFS17.kicad_pcb, IF_Frontend_J310_BFS17.kicad_sch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]
2026-08-14 Added silkscreen art to PCB
    Labels on bottom side, primarily
    [PWR_RPM5.0_AP2114-B_Cu.gbl, PWR_RPM5.0_AP2114-B_Mask.gbs, PWR_RPM5.0_AP2114-B_Paste.gbp, PWR_RPM5.0_AP2114-B_Silkscreen.gbo, PWR_RPM5.0_AP2114-Edge_Cuts.gm1, PWR_RPM5.0_AP2114-F_Cu.gtl, PWR_RPM5.0_AP2114-F_Mask.gts, PWR_RPM5.0_AP2114-F_Paste.gtp]
2026-08-14 PCB tweaks, generated gerbers
    [PWR_RPM5.0_AP2114-B_Cu.gbl, PWR_RPM5.0_AP2114-B_Mask.gbs, PWR_RPM5.0_AP2114-B_Paste.gbp, PWR_RPM5.0_AP2114-B_Silkscreen.gbo, PWR_RPM5.0_AP2114-Edge_Cuts.gm1, PWR_RPM5.0_AP2114-F_Cu.gtl, PWR_RPM5.0_AP2114-F_Mask.gts, PWR_RPM5.0_AP2114-F_Paste.gtp]
2026-08-14 Fixed Silkscreen, regenerated gerbers
    [PWR_RPM5.0_AP2114-B_Cu.gbl, PWR_RPM5.0_AP2114-B_Mask.gbs, PWR_RPM5.0_AP2114-B_Paste.gbp, PWR_RPM5.0_AP2114-B_Silkscreen.gbo, PWR_RPM5.0_AP2114-Edge_Cuts.gm1, PWR_RPM5.0_AP2114-F_Cu.gtl, PWR_RPM5.0_AP2114-F_Mask.gts, PWR_RPM5.0_AP2114-F_Paste.gtp]
2026-08-14 Silkscreen tweaks
    [PWR_RPM5.0_AP2114-B_Cu.gbl, PWR_RPM5.0_AP2114-B_Mask.gbs, PWR_RPM5.0_AP2114-B_Paste.gbp, PWR_RPM5.0_AP2114-B_Silkscreen.gbo, PWR_RPM5.0_AP2114-Edge_Cuts.gm1, PWR_RPM5.0_AP2114-F_Cu.gtl, PWR_RPM5.0_AP2114-F_Mask.gts, PWR_RPM5.0_AP2114-F_Paste.gtp]
2026-08-14 Started Si5351 module
    [ClockGen_Si5351X_QFN16.kicad_pcb, ClockGen_Si5351X_QFN16.kicad_sch]
2026-08-17 Rev A of schematic completed
    [ClockGen_Si5351X_QFN16.kicad_sch]
2026-08-17 Added support for Si5351A and Si5351C
    Quite a clever setup, if I do say so myself
    [ClockGen_Si5351X_QFN16.kicad_sch]
2026-08-17 Added solderpad jumpers
    [ClockGen_Si5351X_QFN16.kicad_sch]
2026-08-18 Corrected breadboard width
    Gave me a chance to rearrange some of the 3V3 stuff, looks much healthier now
    [PWR_RPM5.0_AP2114-B_Cu.gbl, PWR_RPM5.0_AP2114-B_Mask.gbs, PWR_RPM5.0_AP2114-B_Paste.gbp, PWR_RPM5.0_AP2114-B_Silkscreen.gbo, PWR_RPM5.0_AP2114-Edge_Cuts.gm1, PWR_RPM5.0_AP2114-F_Cu.gtl, PWR_RPM5.0_AP2114-F_Mask.gts, PWR_RPM5.0_AP2114-F_Paste.gtp]
2026-08-18 PCB layout begins
    [ClockGen_Si5351X_QFN16.kicad_pcb, ClockGen_Si5351X_QFN16.kicad_sch]
2026-08-20 Most PCB layout done
    [ClockGen_Si5351X_QFN16.kicad_pcb, ClockGen_Si5351X_QFN16.kicad_sch]
2026-08-24 PCB Layout finished
    Need to tweak silkscreen and add art and stuff
    [ClockGen_Si5351X_QFN16.kicad_pcb, ClockGen_Si5351X_QFN16.kicad_sch]
2026-08-24 Modified designn to include LM66200
    PCB layout edits in progress
    [ClockGen_Si5351X_QFN16.kicad_pcb, ClockGen_Si5351X_QFN16.kicad_sch]
2026-08-25 PCB Layout
    [ClockGen_Si5351X_QFN16.kicad_pcb, ClockGen_Si5351X_QFN16.kicad_sch]
2026-08-26 Replaced Q2 with GSFJ0300
    Lower Rds, smaller footprint, parts commonality with Q1
    [ClockGen_Si5351X_QFN16.kicad_pcb, ClockGen_Si5351X_QFN16.kicad_sch]
2026-08-26 Silkscreen art added
    [ClockGen_Si5351X_QFN16.kicad_pcb, ClockGen_Si5351X_QFN16.kicad_sch]
2026-08-26 Generated Rev A Gerber Files
    [ClockGen_Si5351X_QFN16-B_Cu.gbl, ClockGen_Si5351X_QFN16-B_Mask.gbs, ClockGen_Si5351X_QFN16-B_Paste.gbp, ClockGen_Si5351X_QFN16-B_Silkscreen.gbo, ClockGen_Si5351X_QFN16-Edge_Cuts.gm1, ClockGen_Si5351X_QFN16-F_Cu.gtl, ClockGen_Si5351X_QFN16-F_Mask.gts, ClockGen_Si5351X_QFN16-F_Paste.gtp]
2026-08-27 RTL Module Schematic
    [ClockGen_Si5351X_QFN16.kicad_pcb, SDR_2832U_R820T2.kicad_sch]
2026-08-27 Placed footprints on PCB
    [SDR_2832U_R820T2.kicad_pcb, SDR_2832U_R820T2.kicad_sch]
2026-08-28 Fixed NCV68601 Footprint
    Had the wrong pinout, glad I caught this!
    [ClockGen_Si5351X_QFN16-B_Cu.gbl, ClockGen_Si5351X_QFN16-B_Mask.gbs, ClockGen_Si5351X_QFN16-B_Paste.gbp, ClockGen_Si5351X_QFN16-B_Silkscreen.gbo, ClockGen_Si5351X_QFN16-Edge_Cuts.gm1, ClockGen_Si5351X_QFN16-F_Cu.gtl, ClockGen_Si5351X_QFN16-F_Mask.gts, ClockGen_Si5351X_QFN16-F_Paste.gtp]
2026-09-01 PCB Layout Completed
    Now I need to do the silkscreen stuffs...
    [SDR_2832U_R820T2.kicad_pcb, SDR_2832U_R820T2.kicad_sch]
2026-09-01 Silkscreen mostly done
    Need to label the test points and connectors
    [SDR_2832U_R820T2.kicad_pcb]
2026-09-02 Added termination resistors to CLK lines
    And did some silkscreen tweaks
    [SDR_2832U_R820T2.kicad_pcb, SDR_2832U_R820T2.kicad_sch]
2026-09-03 Added input power snubber
    Just in case :P
    [ClockGen_Si5351X_QFN16-B_Cu.gbl, ClockGen_Si5351X_QFN16-B_Mask.gbs, ClockGen_Si5351X_QFN16-B_Paste.gbp, ClockGen_Si5351X_QFN16-B_Silkscreen.gbo, ClockGen_Si5351X_QFN16-Edge_Cuts.gm1, ClockGen_Si5351X_QFN16-F_Cu.gtl, ClockGen_Si5351X_QFN16-F_Mask.gts, ClockGen_Si5351X_QFN16-F_Paste.gtp]
